frchp/open-lion-charger/README.md

# open-lion-charger
Open source battery charger and discharger

Based on [private archived project](https://github.com/frchp/li-ion-battery-high-current-charger)

TODO :
  1. Manufacturing
  2. Arduino software/library for easy integration
