frchp/open-lion-charger/hw/open-lion-charger/open-lion-charger.kicad_pcb

## KiCad design hw/open-lion-charger/open-lion-charger.kicad_pcb (2025-02-10)

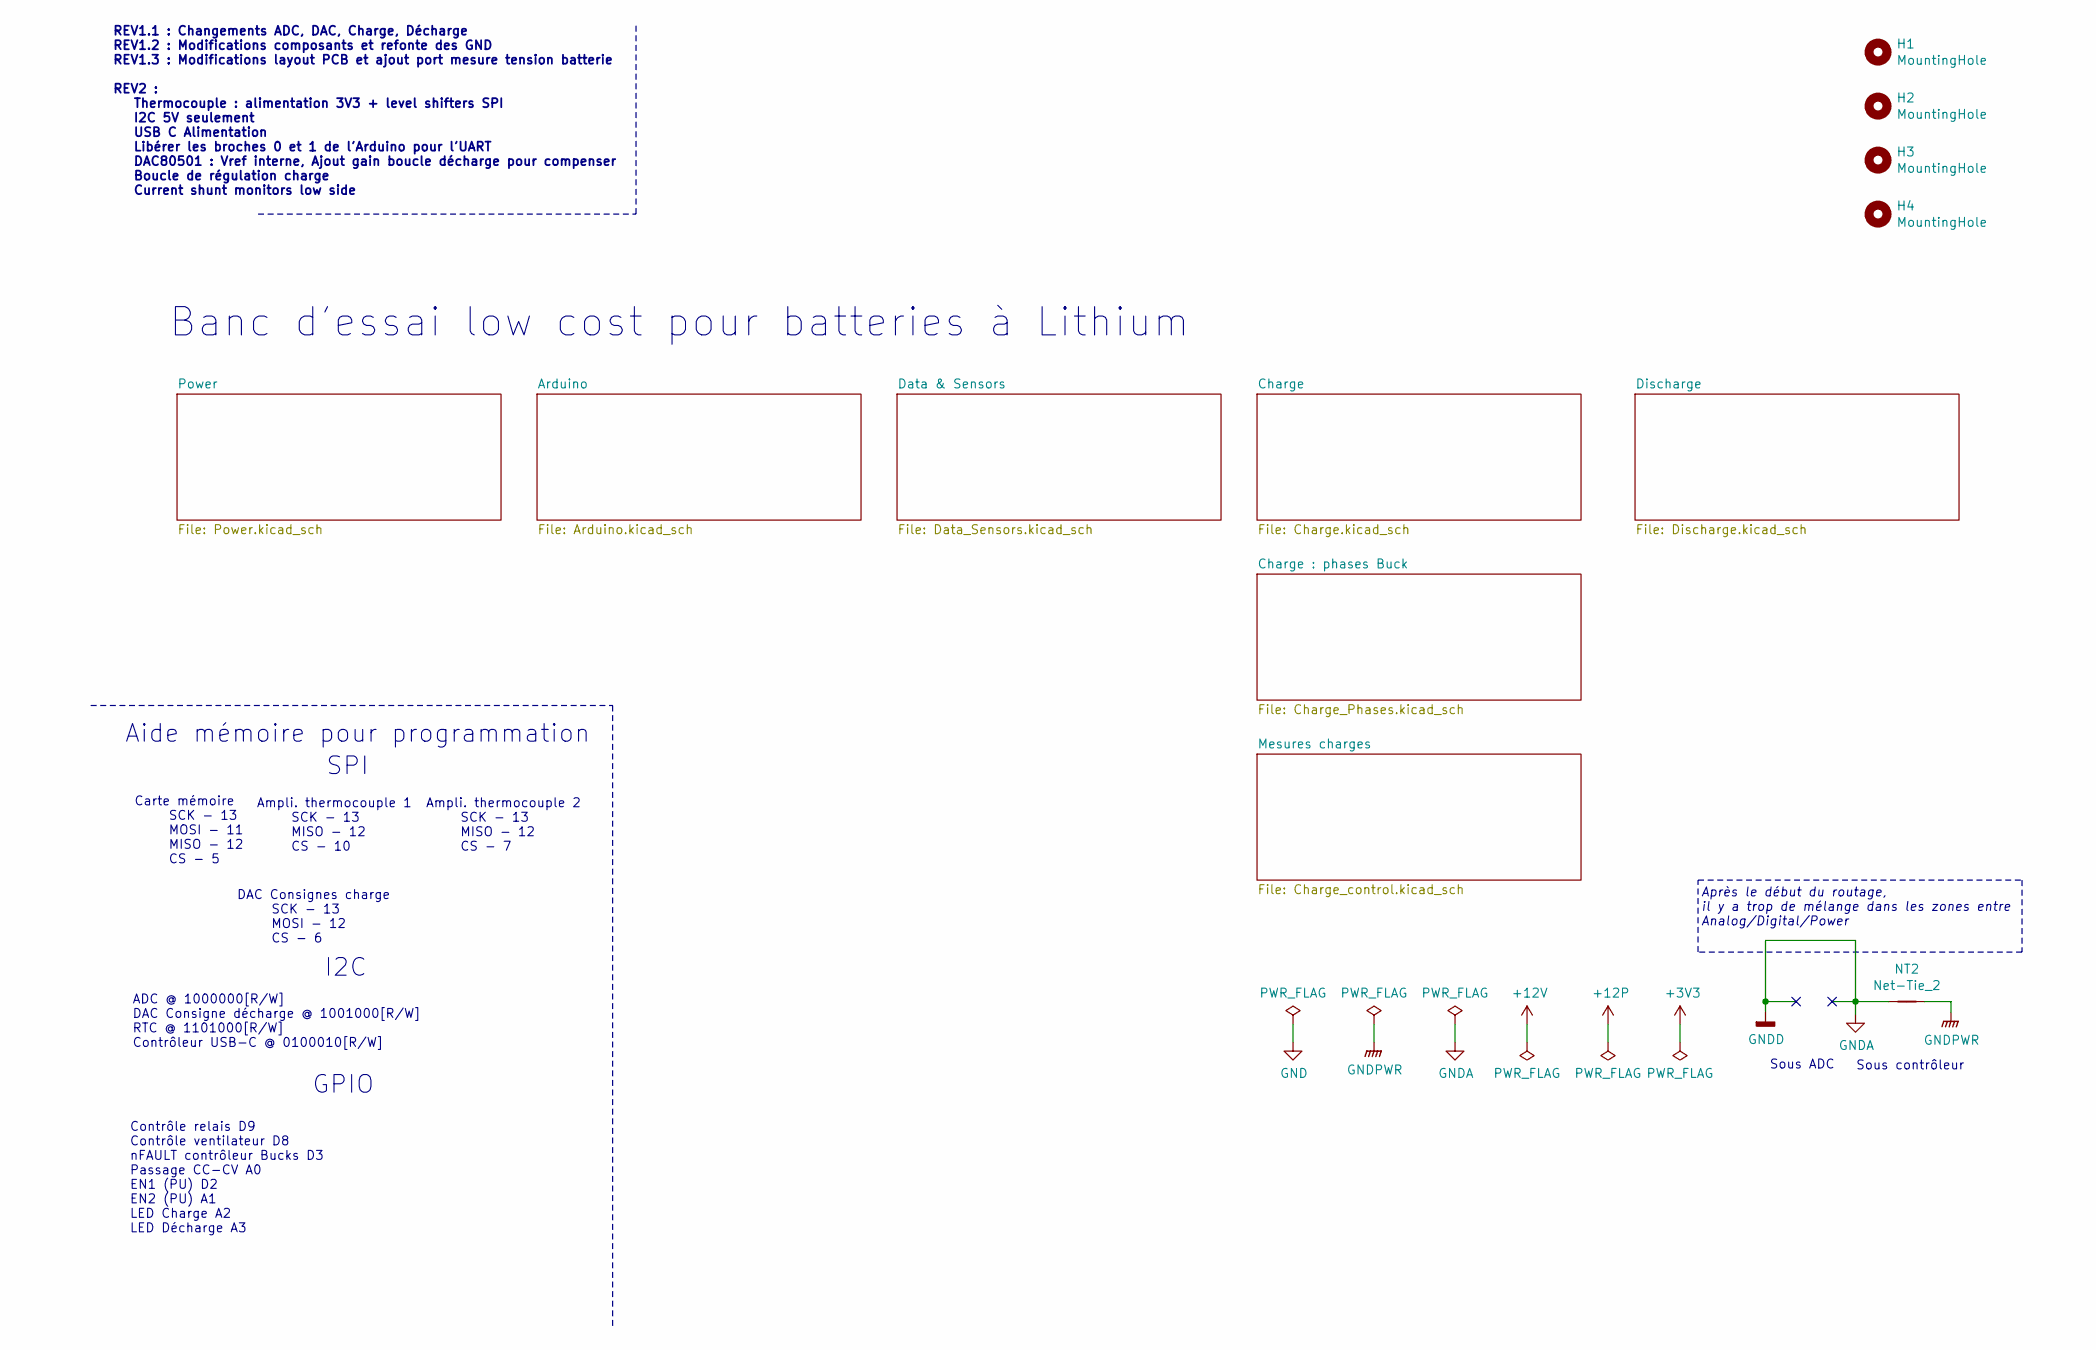
[picture p1: schematic open-lion-charger.kicad_sch, Open LiOn charger]

Parts:
H1, H2, H3, H4: MountingHole; MountingHole_3.2mm_M3_ISO7380
NT2: Net-Tie_2; NetTie-2_SMD_Pad0.5mm

Connections:
GNDA: NT2.1; also elsewhere on the board
GNDPWR: NT2.2; also elsewhere on the board

Notes on the sheet:
Carte mémoire SCK - 13 MOSI - 11 MISO - 12 CS - 5
Ampli. thermocouple 1 SCK - 13 MISO - 12 CS - 10
I2C
Ampli. thermocouple 2 SCK - 13 MISO - 12 CS - 7
REV1.1 : Changements ADC, DAC, Charge, Décharge REV1.2 : Modifications composants et refonte des GND REV1.3 : Modifications layout PCB et ajout port mesure tension batterie REV2 : Thermocouple : alimentation 3V3 + level shifters SPI I2C 5V seulement USB C Alimentation Libérer les broches 0 et 1 de 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
GPIO
Sous contrôleur
DAC Consignes charge SCK - 13 MOSI - 12 CS - 6
Aide mémoire pour programmation
ADC @ 1000000[R/W] DAC Consigne décharge @ 1001000[R/W] RTC @ 1101000[R/W] Contrôleur USB-C @ 0100010[R/W]
Sous ADC
SPI
Contrôle relais D9 Contrôle ventilateur D8 nFAULT contrôleur Bucks D3 Passage CC-CV A0 EN1 (PU) D2 EN2 (PU) A1 LED Charge A2 LED Décharge A3
Après le début du routage, il y a trop de mélange dans les zones entre Analog/Digital/Power
Banc d'essai low cost pour batteries à Lithium

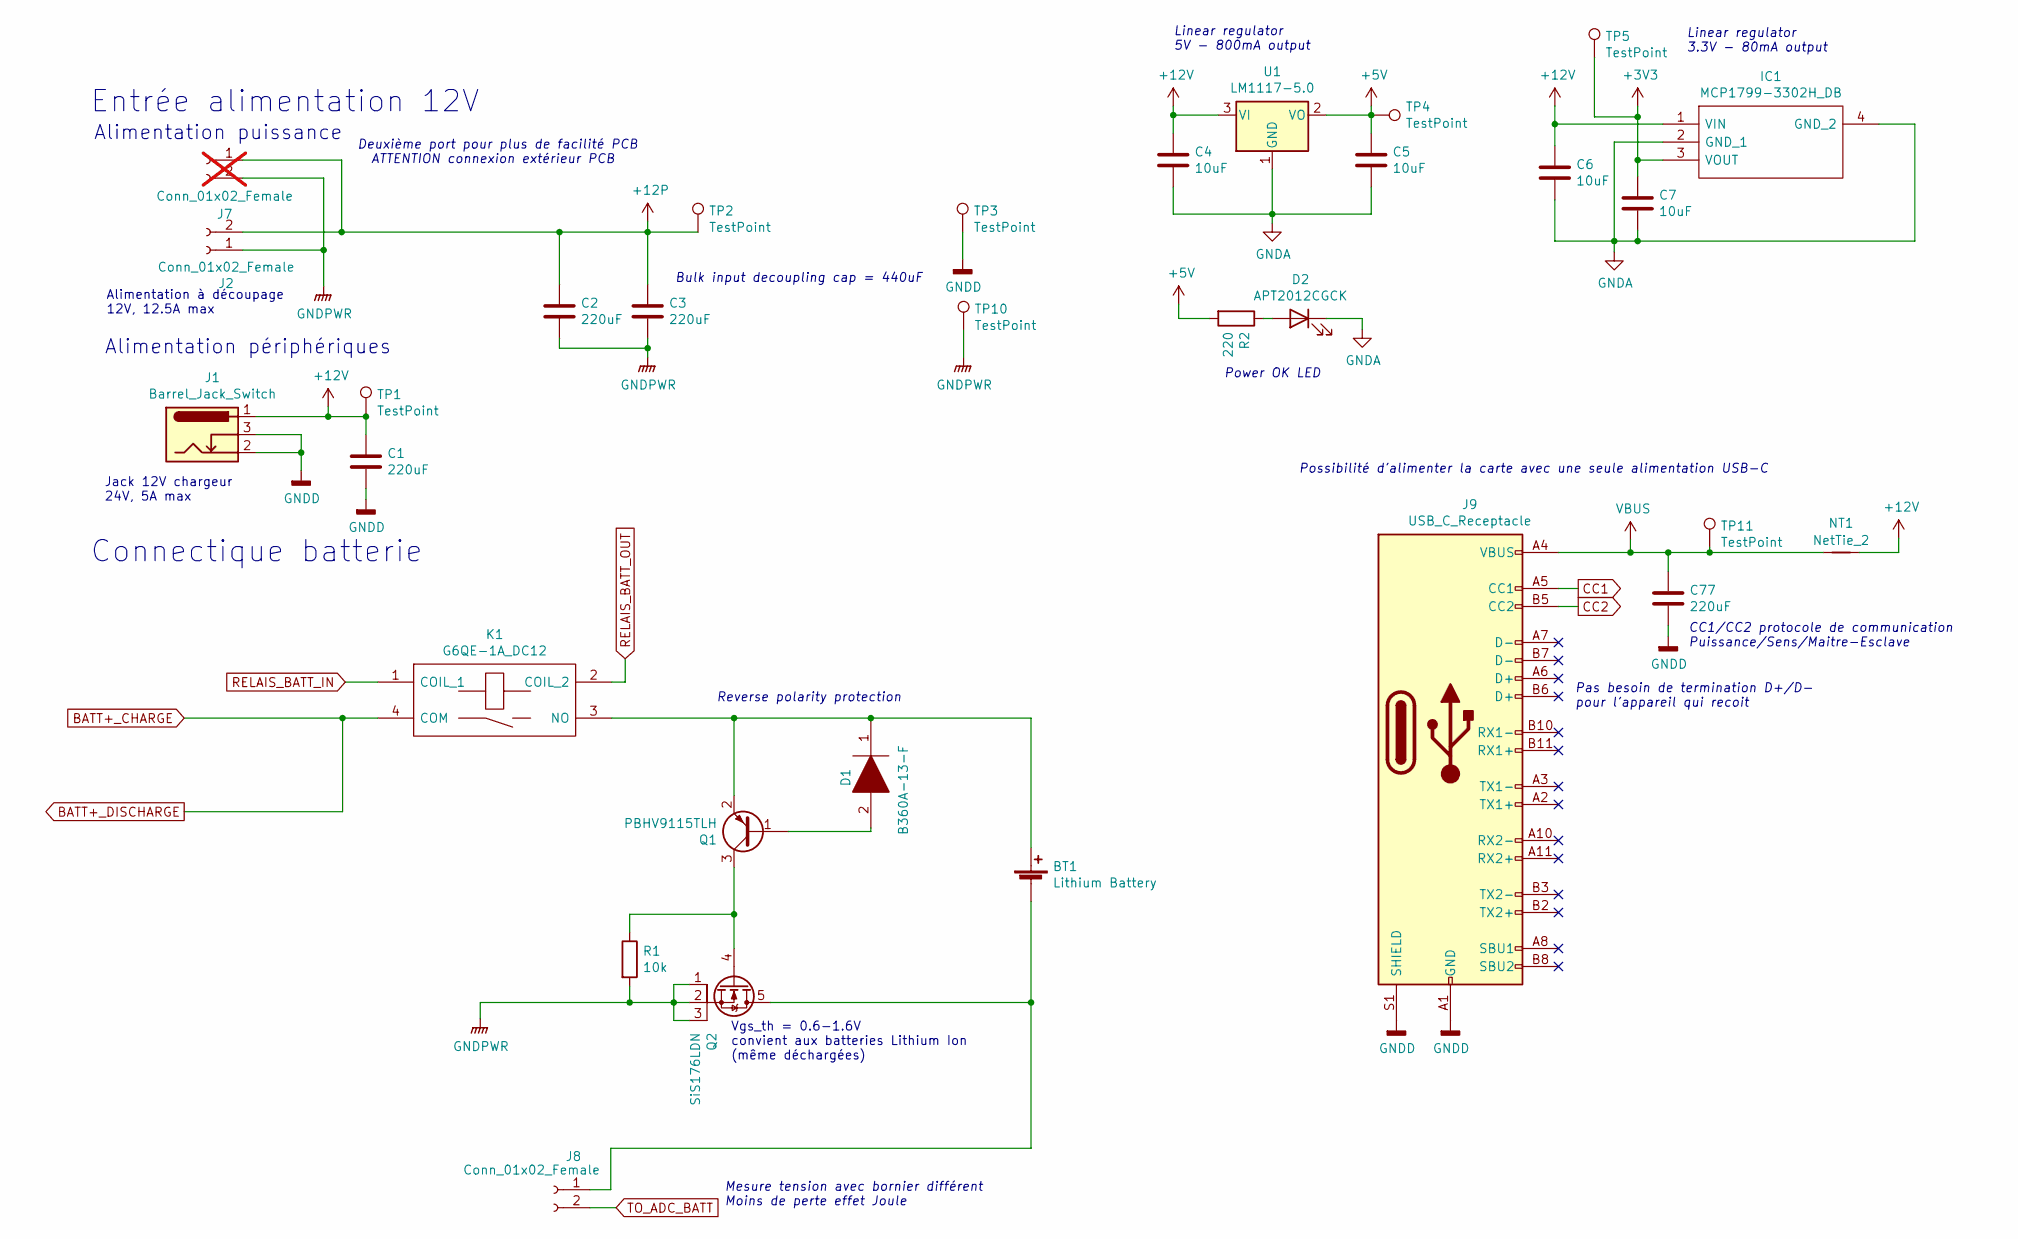
[picture p2: schematic Power.kicad_sch]

Parts:
BT1: Lithium Battery; TerminalBlock_bornier-2_P5.08mm
C1, C2, C3, C77: 220uF; CP_EIA-7343-31_Kemet-D_Pad2.25x2.55mm_HandSolder
C4, C5, C6, C7: 10uF; C_0805_2012Metric
D1: B360A-13-F; DIOM5226X240N; Manufacturer_Part_Number B360A-13-F; Mouser Part Number 621-B360A-F
D2: APT2012CGCK; LED_0805_2012Metric_Pad1.15x1.40mm_HandSolder
IC1: MCP1799-3302H_DB; SOT230P700X180-4N; Manufacturer_Part_Number MCP1799-3302H/DB; Mouser Part Number 579-MCP1799-3302H/DB
J1: Barrel_Jack_Switch; BarrelJack_Wuerth_6941xx301002
J2, J8: Conn_01x02_Female; TerminalBlock_bornier-2_P5.08mm
J7: Conn_01x02_Female; TerminalBlock_bornier-2_P5.08mm; not fitted
J9: USB_C_Receptacle; USB_C_Receptacle_GCT_USB4085
K1: G6QE-1A_DC12; G6QE1ADC12; Manufacturer_Part_Number G6QE-1A DC12; Mouser Part Number 653-G6QE-1ADC12
NT1: NetTie_2; R_2816_7142Metric_Pad3.20x4.45mm_HandSolder
Q1: PBHV9115TLH; SOT-23
Q2: SiS176LDN; Vishay_PowerPAK_1212-8_Single
R1: 10k; R_0805_2012Metric
R2: 220; R_0805_2012Metric
TP1, TP2, TP3, TP4, TP5, TP10, TP11: TestPoint; TestPoint_Keystone_5000-5004_Miniature
U1: LM1117-5.0; SOT-223

Connections:
+3V3: C7.1, IC1.3 (VOUT), TP5.1; also elsewhere on the board
+5V: C5.1, R2.2, TP4.1, U1.2 (VO); also elsewhere on the board
+12P: C2.1, C3.1, J2.2, J7.1, TP2.1; also elsewhere on the board
BATT+_CHARGE: K1.4 (COM); also elsewhere on the board
CC1: J9.A5 (CC1); also elsewhere on the board
CC2: J9.B5 (CC2); also elsewhere on the board
GNDA: C1.2, C4.2, C5.2, C6.2, C7.2, C77.2, D2.1 (K), IC1.2 (GND_1), IC1.4 (GND_2), J1.2, J1.3, J9.A1 (GND), J9.A12 (GND), J9.B1 (GND), J9.B12 (GND), J9.S1 (SHIELD), TP3.1, U1.1 (GND); also elsewhere on the board
GNDPWR: C2.2, C3.2, J2.1, J7.2, Q2.1, Q2.2, Q2.3, R1.2, TP10.1; also elsewhere on the board
unnamed: BT1.1 (+), D1.1, K1.3 (NO), Q1.2 (E)
unnamed: BT1.2 (-), J8.1, Q2.5
unnamed: D2.2 (A), R2.1
unnamed: D1.2, Q1.1 (B)
unnamed: Q1.3 (C), Q2.4, R1.1
RELAIS_BATT_IN: K1.1 (COIL_1); also elsewhere on the board
RELAIS_BATT_OUT: C1.1, C4.1, C6.1, IC1.1 (VIN), J1.1, K1.2 (COIL_2), NT1.2, TP1.1, U1.3 (VI); also elsewhere on the board
TO_ADC_BATT: J8.2; also elsewhere on the board
VBUS: C77.1, J9.A4 (VBUS), J9.A9 (VBUS), J9.B4 (VBUS), J9.B9 (VBUS), NT1.1, TP11.1; also elsewhere on the board

Notes on the sheet:
Alimentation à découpage 12V, 12.5A max
Connectique batterie
Entrée alimentation 12V
Deuxième port pour plus de facilité PCB ATTENTION connexion extérieur PCB
Bulk input decoupling cap = 440uF
CC1/CC2 protocole de communication Puissance/Sens/Maitre-Esclave
Alimentation périphériques
Jack 12V chargeur 24V, 5A max
Power OK LED
Pas besoin de termination D+/D- pour l'appareil qui recoit
Vgs_th = 0.6-1.6V convient aux batteries Lithium Ion (même déchargées)
Alimentation puissance
Mesure tension avec bornier différent Moins de perte effet Joule
Linear regulator 5V - 800mA output
Reverse polarity protection
Possibilité d'alimenter la carte avec une seule alimentation USB-C
Linear regulator 3.3V - 80mA output

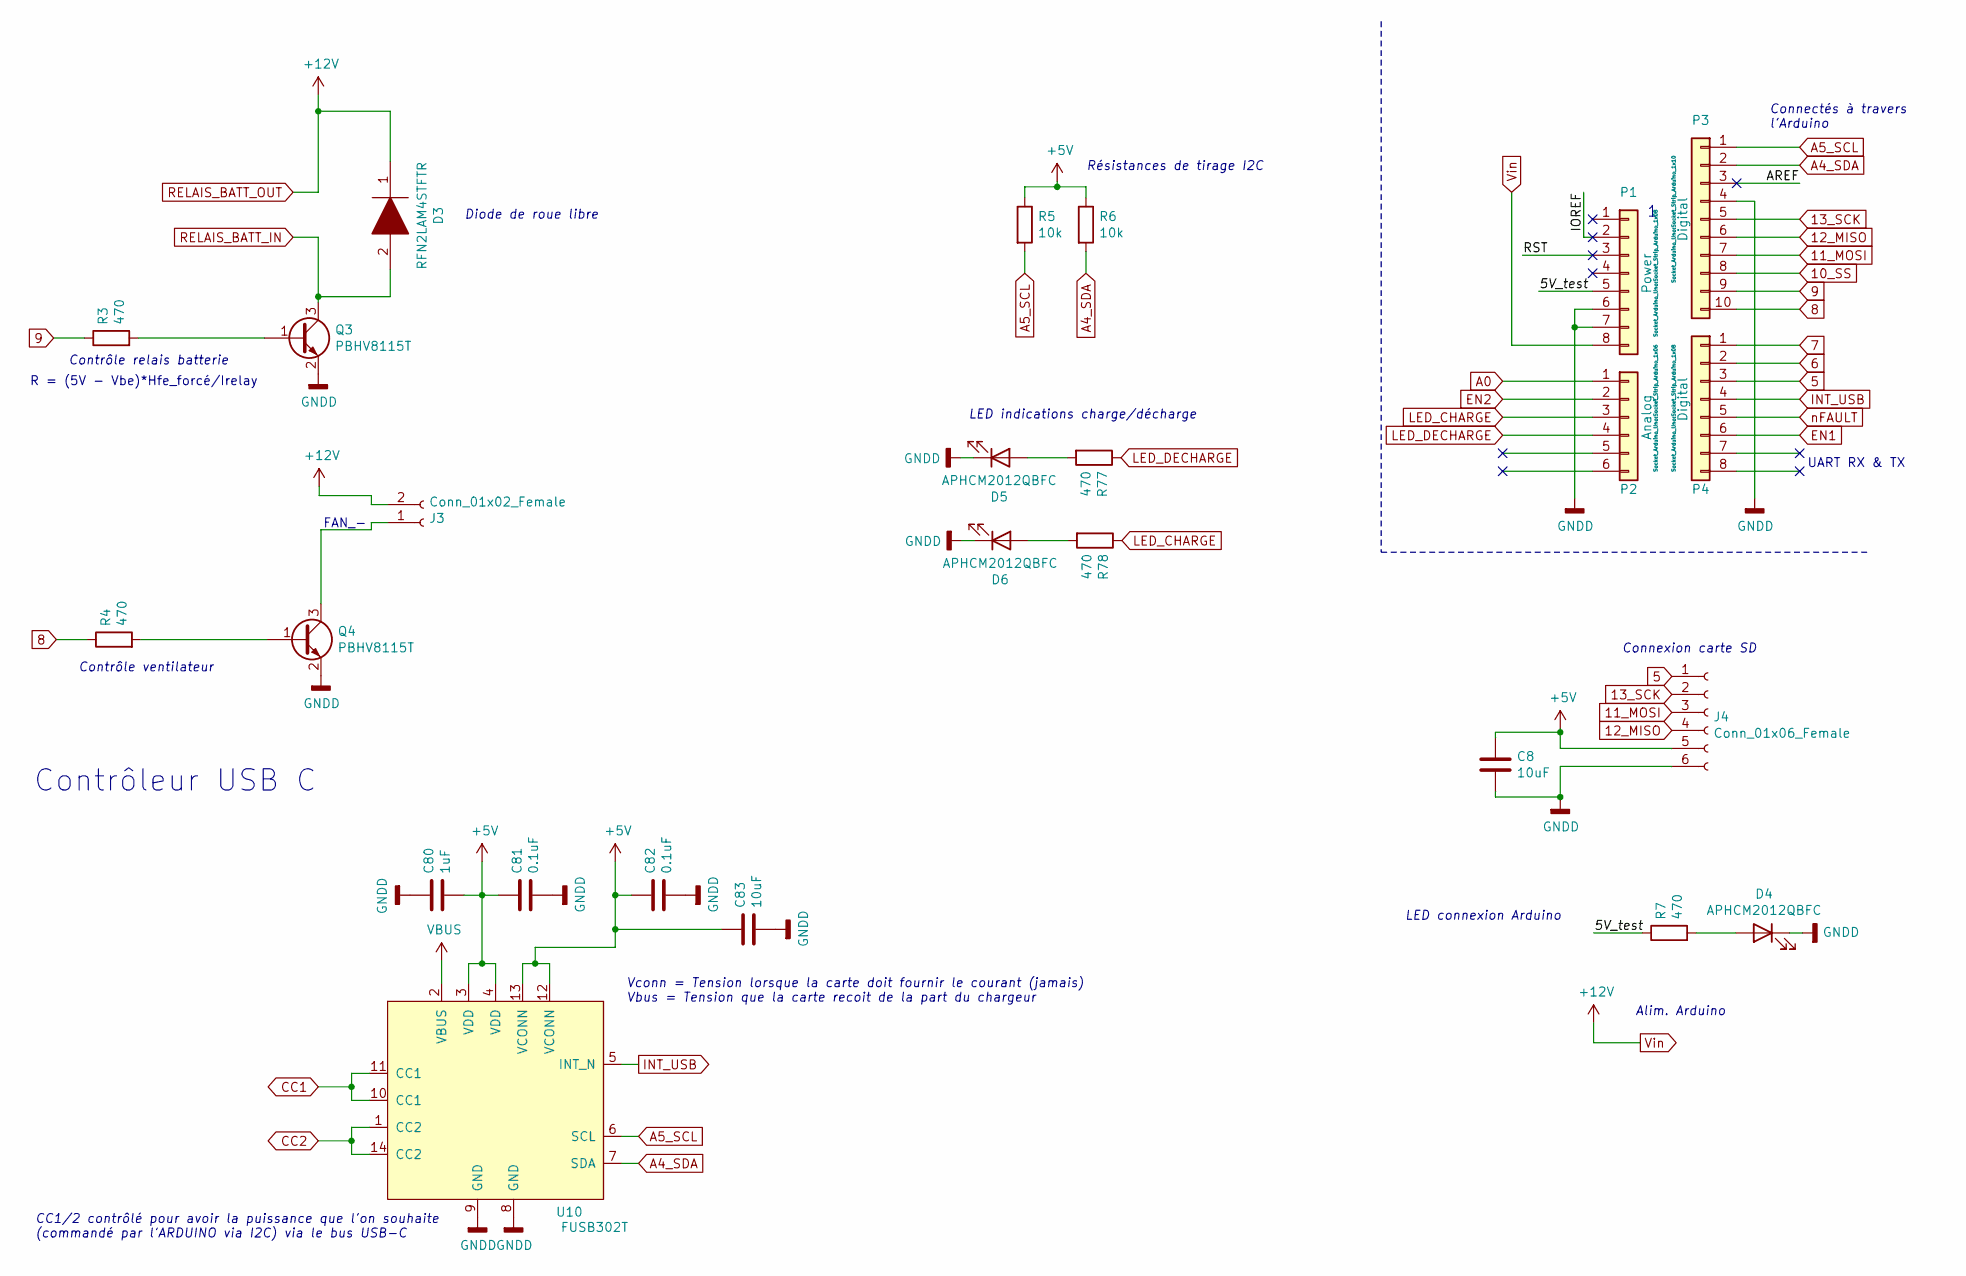
[picture p3: schematic Arduino.kicad_sch]

Parts:
C8, C83: 10uF; C_0805_2012Metric
C80: 1uF; C_0805_2012Metric
C81, C82: 0.1uF; C_0805_2012Metric
D3: RFN2LAM4STFTR; SODFL4725X105N; Manufacturer_Part_Number RFN2LAM4STFTR; Mouser Part Number 755-RFN2LAM4STFTR
D4, D5, D6: APHCM2012QBFC; LED_0805_2012Metric_Pad1.15x1.40mm_HandSolder
J3: Conn_01x02_Female; TerminalBlock_bornier-2_P5.08mm
J4: Conn_01x06_Female; PinSocket_1x06_P2.54mm_Vertical
P1: Power; Socket_Strip_Arduino_1x08
P2: Analog; Socket_Strip_Arduino_1x06
P3: Digital; Socket_Strip_Arduino_1x10
P4: Digital; Socket_Strip_Arduino_1x08
Q3, Q4: PBHV8115T; SOT-23
R3, R4, R7, R77, R78: 470; R_0805_2012Metric
R5, R6: 10k; R_0805_2012Metric
U10: FUSB302T; WQFN-14-1EP_2.5x2.5mm_P0.5mm_EP1.45x1.45mm

Connections:
5: J4.1, P4.3
6: P4.2; also elsewhere on the board
7: P4.1; also elsewhere on the board
8: P3.10, R4.1
9: P3.9, R3.1
10_SS: P3.8; also elsewhere on the board
11_MOSI: J4.3, P3.7; also elsewhere on the board
12_MISO: J4.4, P3.6; also elsewhere on the board
13_SCK: J4.2, P3.5; also elsewhere on the board
+5V: C8.1, C80.2, C81.1, C82.1, C83.1, J4.5, R5.1, R6.1, U10.3 (VDD), U10.4 (VDD), U10.12 (VCONN), U10.13 (VCONN); also elsewhere on the board
/Arduino/5V_test: P1.5, R7.1
/Arduino/AREF: P3.3
/Arduino/IOREF: P1.2
/Arduino/RST: P1.3
A0: P2.1; also elsewhere on the board
A4_SDA: P3.2, R6.2, U10.7 (SDA); also elsewhere on the board
A5_SCL: P3.1, R5.2, U10.6 (SCL); also elsewhere on the board
CC1: U10.10 (CC1), U10.11 (CC1); also elsewhere on the board
CC2: U10.1 (CC2), U10.14 (CC2); also elsewhere on the board
EN1: P4.6; also elsewhere on the board
EN2: P2.2; also elsewhere on the board
GNDA: C8.2, C80.1, C81.2, C82.2, C83.2, D4.1 (K), D5.1 (K), D6.1 (K), J4.6, P1.6, P1.7, P3.4, Q3.2 (E), Q4.2 (E), U10.8 (GND), U10.9 (GND); also elsewhere on the board
INT_USB: P4.4, U10.5 (INT_N)
LED_CHARGE: P2.3, R78.1
LED_DECHARGE: P2.4, R77.1
unnamed: D4.2 (A), R7.2
unnamed: D5.2 (A), R77.2
unnamed: D6.2 (A), R78.2
unnamed: J3.1, Q4.3 (C)
unnamed: Q3.1 (B), R3.2
unnamed: Q4.1 (B), R4.2
RELAIS_BATT_IN: D3.2, Q3.3 (C); also elsewhere on the board
RELAIS_BATT_OUT: D3.1, J3.2, P1.8; also elsewhere on the board
VBUS: U10.2 (VBUS); also elsewhere on the board
nFAULT: P4.5; also elsewhere on the board

Notes on the sheet:
FAN_-
Alim. Arduino
Diode de roue libre
Contrôleur USB C
Connexion carte SD
Résistances de tirage I2C
R = (5V - Vbe)*Hfe_forcé/Irelay
LED indications charge/décharge
LED connexion Arduino
Vconn = Tension lorsque la carte doit fournir le courant (jamais) Vbus = Tension que la carte recoit de la part du chargeur
Connectés à travers l'Arduino
CC1/2 contrôlé pour avoir la puissance que l'on souhaite (commandé par l'ARDUINO via I2C) via le bus USB-C
Contrôle relais batterie
Contrôle ventilateur
UART RX & TX

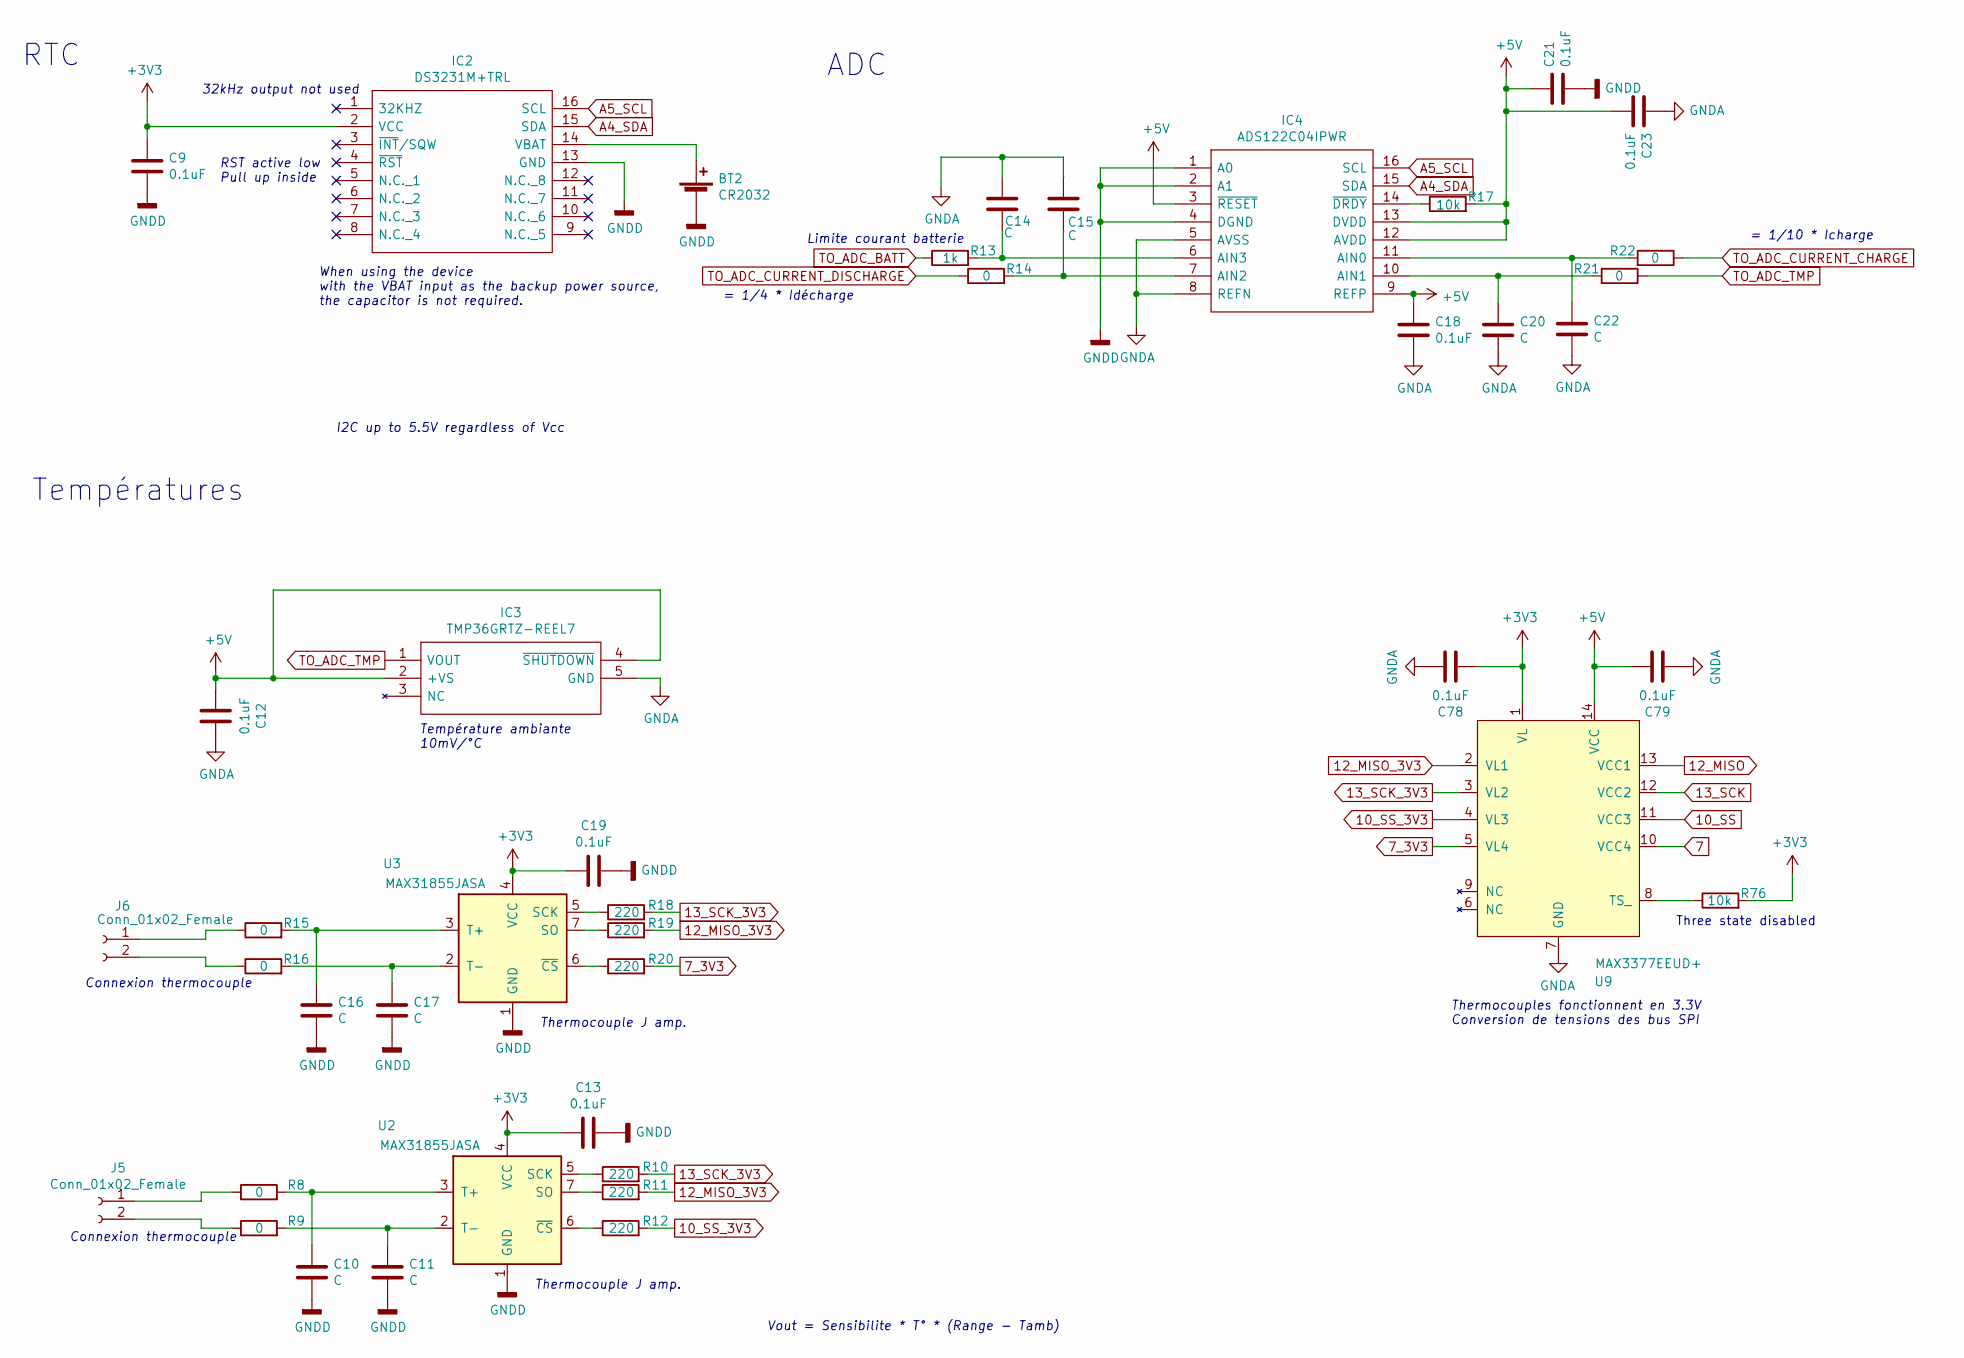
[picture p4: schematic Data_Sensors.kicad_sch]

Parts:
BT2: CR2032; BATHLD001TR
C9, C12, C13, C18, C19, C21, C23, C78, C79: 0.1uF; C_0805_2012Metric
C10, C11, C14, C15, C16, C17, C20, C22: C; C_0805_2012Metric
IC2: DS3231M+TRL; SOIC127P1032X265-16N; Manufacturer_Part_Number DS3231M+TRL; Mouser Part Number 700-DS3231M+TRL
IC3: TMP36GRTZ-REEL7; SOT95P280X145-5N; Manufacturer_Part_Number TMP36GRTZ-REEL7; Mouser Part Number 584-TMP36GRTZ-R7
IC4: ADS122C04IPWR; SOP65P640X120-16N; Manufacturer_Part_Number ADS122C04IPWR; Mouser Part Number 595-ADS122C04IPWR
J5, J6: Conn_01x02_Female; PinSocket_2x01_P1.27mm_Vertical
R8, R9, R14, R15, R16, R21, R22: 0; R_0805_2012Metric
R10, R11, R12, R18, R19, R20: 220; R_0805_2012Metric
R13: 1k; R_0805_2012Metric
R17, R76: 10k; R_0805_2012Metric
U2, U3: MAX31855JASA; SOIC-8_3.9x4.9mm_P1.27mm
U9: MAX3377EEUD+; TSSOP-14_4.4x5mm_P0.65mm

Connections:
7: U9.10 (VCC4); also elsewhere on the board
7_3V3: R20.2, U9.5 (VL4)
10_SS: U9.11 (VCC3); also elsewhere on the board
10_SS_3V3: R12.2, U9.4 (VL3)
12_MISO: U9.13 (VCC1); also elsewhere on the board
12_MISO_3V3: R11.2, R19.2, U9.2 (VL1)
13_SCK: U9.12 (VCC2); also elsewhere on the board
13_SCK_3V3: R10.2, R18.2, U9.3 (VL2)
+3V3: C9.1, C13.2, C19.2, C78.2, IC2.2 (VCC), R76.2, U2.4 (VCC), U3.4 (VCC), U9.1 (VL); also elsewhere on the board
+5V: C12.2, C18.1, C21.1, C23.2, C79.2, IC3.2 (+VS), IC3.4 (~SHUTDOWN), IC4.3 (~RESET), IC4.9 (REFP), IC4.12 (AVDD), IC4.13 (DVDD), R17.2, U9.14 (VCC); also elsewhere on the board
A4_SDA: IC2.15 (SDA), IC4.15 (SDA); also elsewhere on the board
A5_SCL: IC2.16 (SCL), IC4.16 (SCL); also elsewhere on the board
FB_COURANT: R14.1; also elsewhere on the board
GNDA: BT2.2 (-), C9.2, C10.1, C11.1, C12.1, C13.1, C14.2, C15.2, C16.1, C17.1, C18.2, C19.1, C20.1, C21.2, C22.1, C23.1, C78.1, C79.1, IC2.13 (GND), IC3.5 (GND), IC4.1 (A0), IC4.2 (A1), IC4.4 (DGND), IC4.5 (AVSS), IC4.8 (REFN), U2.1 (GND), U3.1 (GND), U9.7 (GND); also elsewhere on the board
unnamed: BT2.1 (+), IC2.14 (VBAT)
unnamed: C22.2, IC4.11 (AIN0), R22.2
unnamed: C20.2, IC4.10 (AIN1), R21.2
unnamed: C15.1, IC4.7 (AIN2), R14.2
unnamed: C14.1, IC4.6 (AIN3), R13.2
unnamed: IC4.14 (~DRDY), R17.1
unnamed: J5.1, R8.1
unnamed: J5.2, R9.1
unnamed: J6.1, R15.1
unnamed: J6.2, R16.1
unnamed: R10.1, U2.5 (SCK)
unnamed: R11.1, U2.7 (SO)
unnamed: C10.2, R8.2, U2.3 (T+)
unnamed: C11.2, R9.2, U2.2 (T-)
unnamed: R12.1, U2.6 (~CS)
unnamed: R18.1, U3.5 (SCK)
unnamed: R19.1, U3.7 (SO)
unnamed: C16.2, R15.2, U3.3 (T+)
unnamed: C17.2, R16.2, U3.2 (T-)
unnamed: R20.1, U3.6 (~CS)
unnamed: R76.1, U9.8 (TS_)
TO_ADC_BATT: R13.1; also elsewhere on the board
TO_ADC_CURRENT_CHARGE: R22.1; also elsewhere on the board
TO_ADC_TMP: IC3.1 (VOUT), R21.1

Notes on the sheet:
Limite courant batterie
ADC
= 1/4 * Idécharge
Thermocouple J amp.
Connexion thermocouple
RTC
Température ambiante 10mV/°C
32kHz output not used
When using the device with the VBAT input as the backup power source, the capacitor is not required.
I2C up to 5.5V regardless of Vcc
Températures
Three state disabled
Thermocouples fonctionnent en 3.3V Conversion de tensions des bus SPI
= 1/10 * Icharge
Vout = Sensibilite * T° * (Range - Tamb)
RST active low Pull up inside

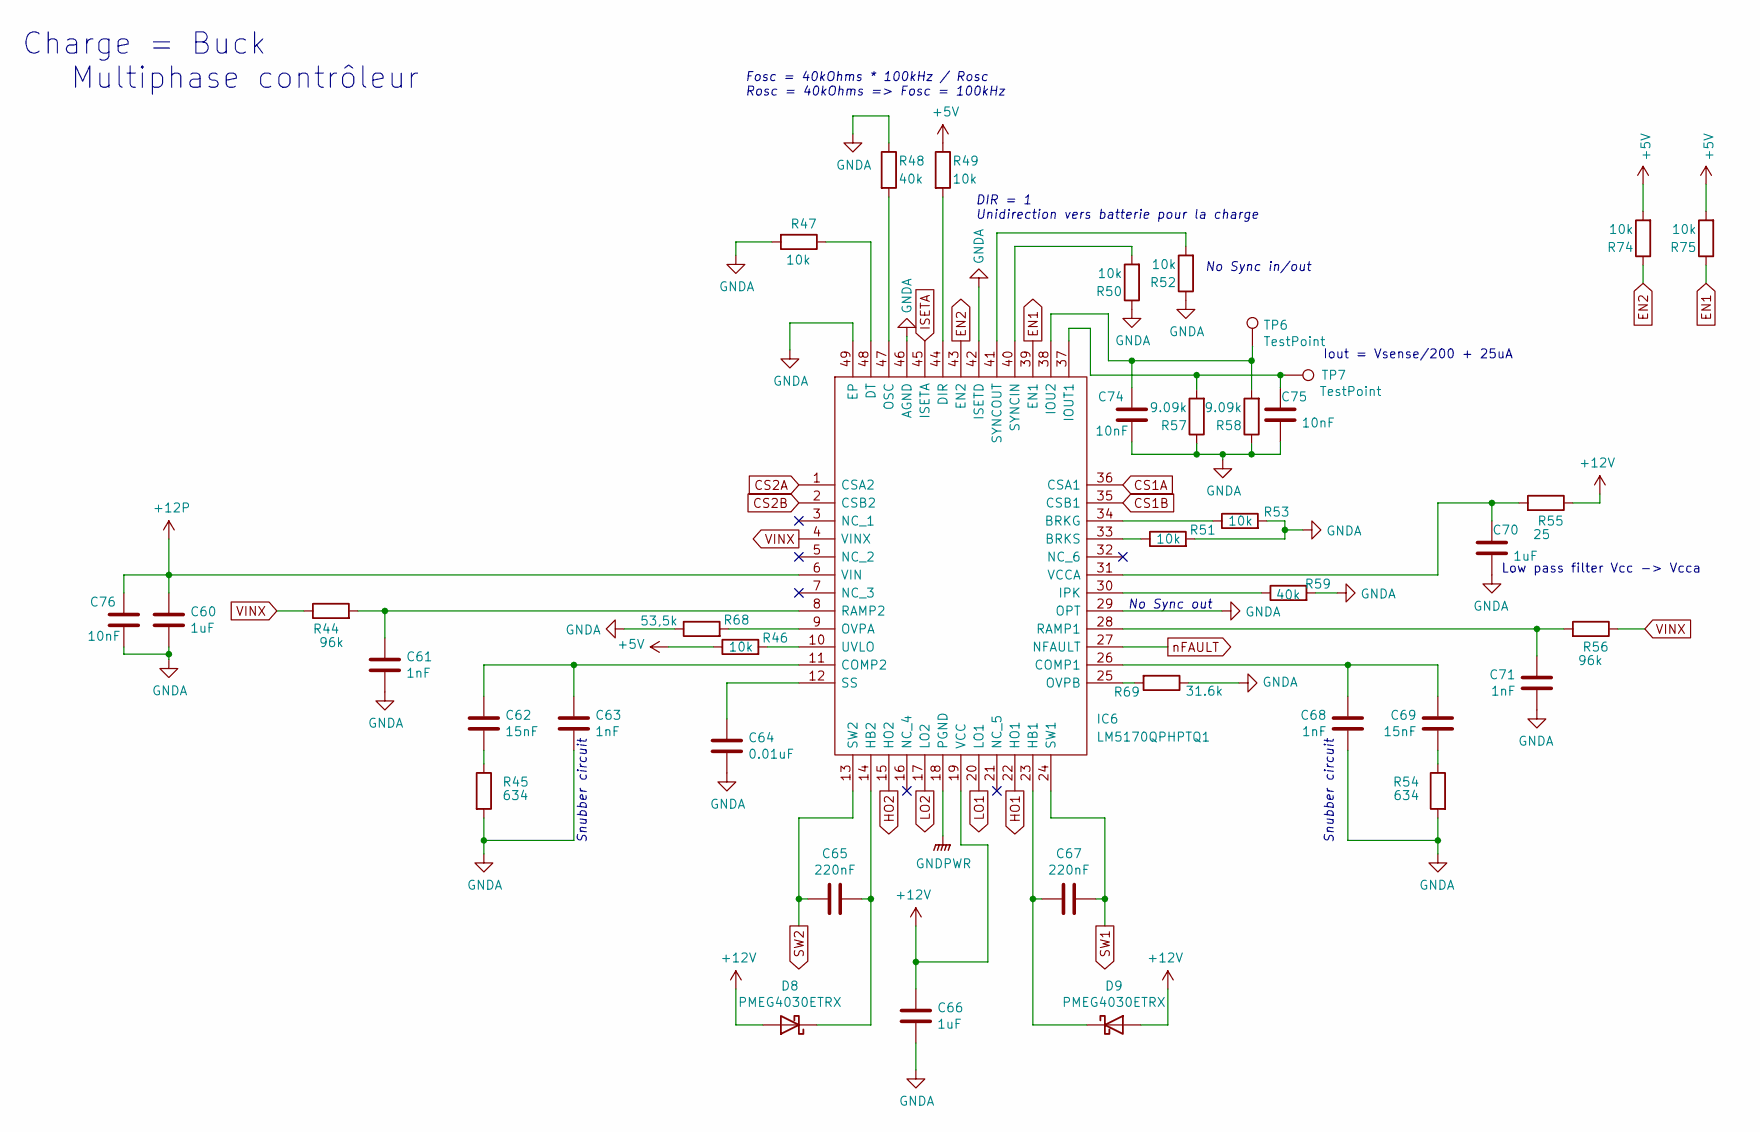
[picture p5: schematic Charge.kicad_sch]

Parts:
C60, C66, C70: 1uF; C_0805_2012Metric
C61, C63, C68, C71: 1nF; C_0805_2012Metric
C62, C69: 15nF; C_0805_2012Metric
C64: 0.01uF; C_0805_2012Metric
C65, C67: 220nF; C_0805_2012Metric
C74, C75, C76: 10nF; C_0805_2012Metric
D8, D9: PMEG4030ETRX; SODFL4725X105N
IC6: LM5170QPHPTQ1; QFP50P900X900X120-49N; Manufacturer_Part_Number LM5170QPHPTQ1; Mouser Part Number 595-LM5170QPHPTQ1
R44, R56: 96k; R_0805_2012Metric
R45, R54: 634; R_0805_2012Metric
R46, R47, R49, R50, R51, R52, R53, R74, R75: 10k; R_0805_2012Metric
R48, R59: 40k; R_0805_2012Metric
R55: 25; R_0805_2012Metric
R57, R58: 9.09k; R_0805_2012Metric
R68: 53,5k; R_0805_2012Metric
R69: 31.6k; R_0805_2012Metric
TP6, TP7: TestPoint; TestPoint_Keystone_5000-5004_Miniature

Connections:
+5V: R46.1, R49.1, R74.2, R75.2; also elsewhere on the board
+12P: C60.1, C76.1, IC6.6 (VIN); also elsewhere on the board
CS1A: IC6.36 (CSA1); also elsewhere on the board
CS1B: IC6.35 (CSB1); also elsewhere on the board
CS2A: IC6.1 (CSA2); also elsewhere on the board
CS2B: IC6.2 (CSB2); also elsewhere on the board
EN1: IC6.39 (EN1), R75.1; also elsewhere on the board
EN2: IC6.43 (EN2), R74.1; also elsewhere on the board
GNDA: C60.2, C61.2, C63.2, C64.2, C66.2, C68.2, C70.2, C71.2, C74.2, C75.2, C76.2, IC6.29 (OPT), IC6.42 (ISETD), IC6.46 (AGND), IC6.49 (EP), R45.2, R47.2, R48.1, R50.1, R51.2, R52.1, R53.2, R54.2, R57.1, R58.1, R59.2, R68.1, R69.1; also elsewhere on the board
GNDPWR: IC6.18 (PGND); also elsewhere on the board
HO1: IC6.22 (HO1); also elsewhere on the board
HO2: IC6.15 (HO2); also elsewhere on the board
ISETA: IC6.45 (ISETA); also elsewhere on the board
LO1: IC6.20 (LO1); also elsewhere on the board
LO2: IC6.17 (LO2); also elsewhere on the board
unnamed: C62.2, R45.1
unnamed: C69.2, R54.1
unnamed: C65.2, D8.1 (K), IC6.14 (HB2)
unnamed: C67.2, D9.1 (K), IC6.23 (HB1)
unnamed: IC6.34 (BRKG), R53.1
unnamed: IC6.33 (BRKS), R51.1
unnamed: C68.1, C69.1, IC6.26 (COMP1)
unnamed: C62.1, C63.1, IC6.11 (COMP2)
unnamed: IC6.44 (DIR), R49.2
unnamed: IC6.48 (DT), R47.1
unnamed: C74.1, IC6.38 (IOU2), R58.2, TP6.1
unnamed: C75.1, IC6.37 (IOUT1), R57.2, TP7.1
unnamed: IC6.30 (IPK), R59.1
unnamed: IC6.47 (OSC), R48.2
unnamed: IC6.9 (OVPA), R68.2
unnamed: IC6.25 (OVPB), R69.2
unnamed: C71.1, IC6.28 (RAMP1), R56.2
unnamed: C61.1, IC6.8 (RAMP2), R44.2
unnamed: C64.1, IC6.12 (SS)
unnamed: IC6.40 (SYNCIN), R50.2
unnamed: IC6.41 (SYNCOUT), R52.2
unnamed: IC6.10 (UVLO), R46.2
unnamed: C70.1, IC6.31 (VCCA), R55.2
RELAIS_BATT_OUT: C66.1, D8.2 (A), D9.2 (A), IC6.19 (VCC), R55.1; also elsewhere on the board
SW1: C67.1, IC6.24 (SW1); also elsewhere on the board
SW2: C65.1, IC6.13 (SW2); also elsewhere on the board
VINX: IC6.4 (VINX), R44.1, R56.1
nFAULT: IC6.27 (NFAULT); also elsewhere on the board

Notes on the sheet:
Snubber circuit
Iout = Vsense/200 + 25uA
DIR = 1 Unidirection vers batterie pour la charge
Fosc = 40kOhms * 100kHz / Rosc Rosc = 40kOhms => Fosc = 100kHz
Charge = Buck Multiphase contrôleur
Low pass filter Vcc -> Vcca
No Sync in/out
No Sync out

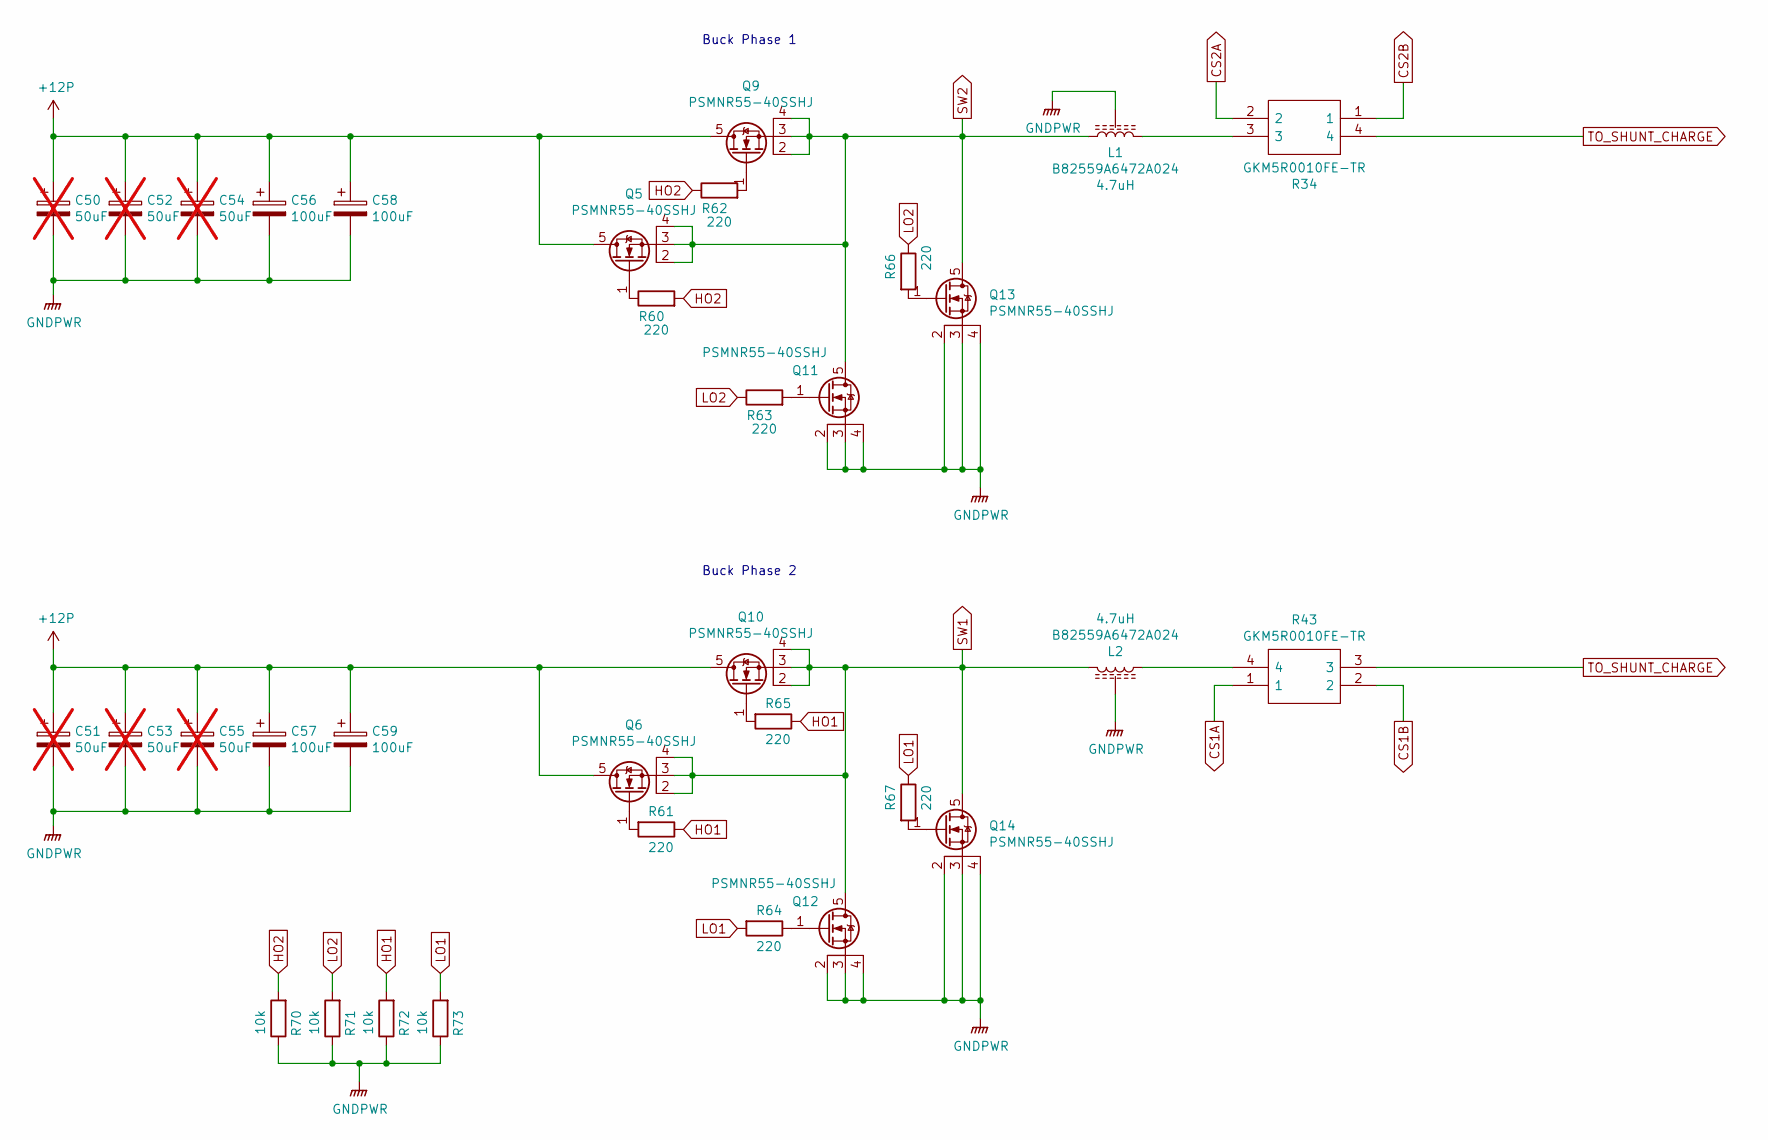
[picture p6: schematic Charge_Phases.kicad_sch]

Parts:
C50, C51, C52, C53, C54, C55: 50uF; SMD_Lytic_E; not fitted
C56, C57, C58, C59: 100uF; EEEFP0J331AV
L1, L2: B82559A6472A024
Q5, Q6, Q9, Q10, Q11, Q12, Q13, Q14: PSMNR55-40SSHJ; LFPAK88
R34, R43: GKM5R0010FE-TR; WSLP40261L000FEA; Manufacturer_Part_Number GKM5R0010FE-TR; Mouser Part Number 588-GKM5R0010FE-TR
R60, R61, R62, R63, R64, R65, R66, R67: 220; R_0805_2012Metric
R70, R71, R72, R73: 10k; R_0805_2012Metric

Connections:
+12P: C50.1, C51.1, C52.1, C53.1, C54.1, C55.1, C56.1, C57.1, C58.1, C59.1, Q5.5, Q6.5, Q9.5, Q10.5; also elsewhere on the board
CS1A: R43.1; also elsewhere on the board
CS1B: R43.2; also elsewhere on the board
CS2A: R34.2; also elsewhere on the board
CS2B: R34.1; also elsewhere on the board
GNDPWR: C50.2, C51.2, C52.2, C53.2, C54.2, C55.2, C56.2, C57.2, C58.2, C59.2, L1.3, L2.3, Q11.2, Q11.3, Q11.4, Q12.2, Q12.3, Q12.4, Q13.2, Q13.3, Q13.4, Q14.2, Q14.3, Q14.4, R70.1, R71.1, R72.1, R73.1; also elsewhere on the board
HO1: R61.1, R65.1, R72.2; also elsewhere on the board
HO2: R60.2, R62.1, R70.2; also elsewhere on the board
LO1: R64.2, R67.1, R73.2; also elsewhere on the board
LO2: R63.1, R66.1, R71.2; also elsewhere on the board
unnamed: L1.2, R34.3
unnamed: L2.1, R43.4
unnamed: Q5.1, R60.1
unnamed: Q6.1, R61.2
unnamed: Q9.1, R62.2
unnamed: Q10.1, R65.2
unnamed: Q11.1, R63.2
unnamed: Q12.1, R64.1
unnamed: Q13.1, R66.2
unnamed: Q14.1, R67.2
SW1: L2.2, Q6.2, Q6.3, Q6.4, Q10.2, Q10.3, Q10.4, Q12.5, Q14.5; also elsewhere on the board
SW2: L1.1, Q5.2, Q5.3, Q5.4, Q9.2, Q9.3, Q9.4, Q11.5, Q13.5; also elsewhere on the board
TO_SHUNT_CHARGE: R34.4, R43.3; also elsewhere on the board

Notes on the sheet:
Buck Phase 2
Buck Phase 1
