frchp/open-lion-charger/hw/open-lion-charger/open-lion-charger.kicad_pcb

## KiCad design hw/open-lion-charger/open-lion-charger.kicad_pcb (continued)

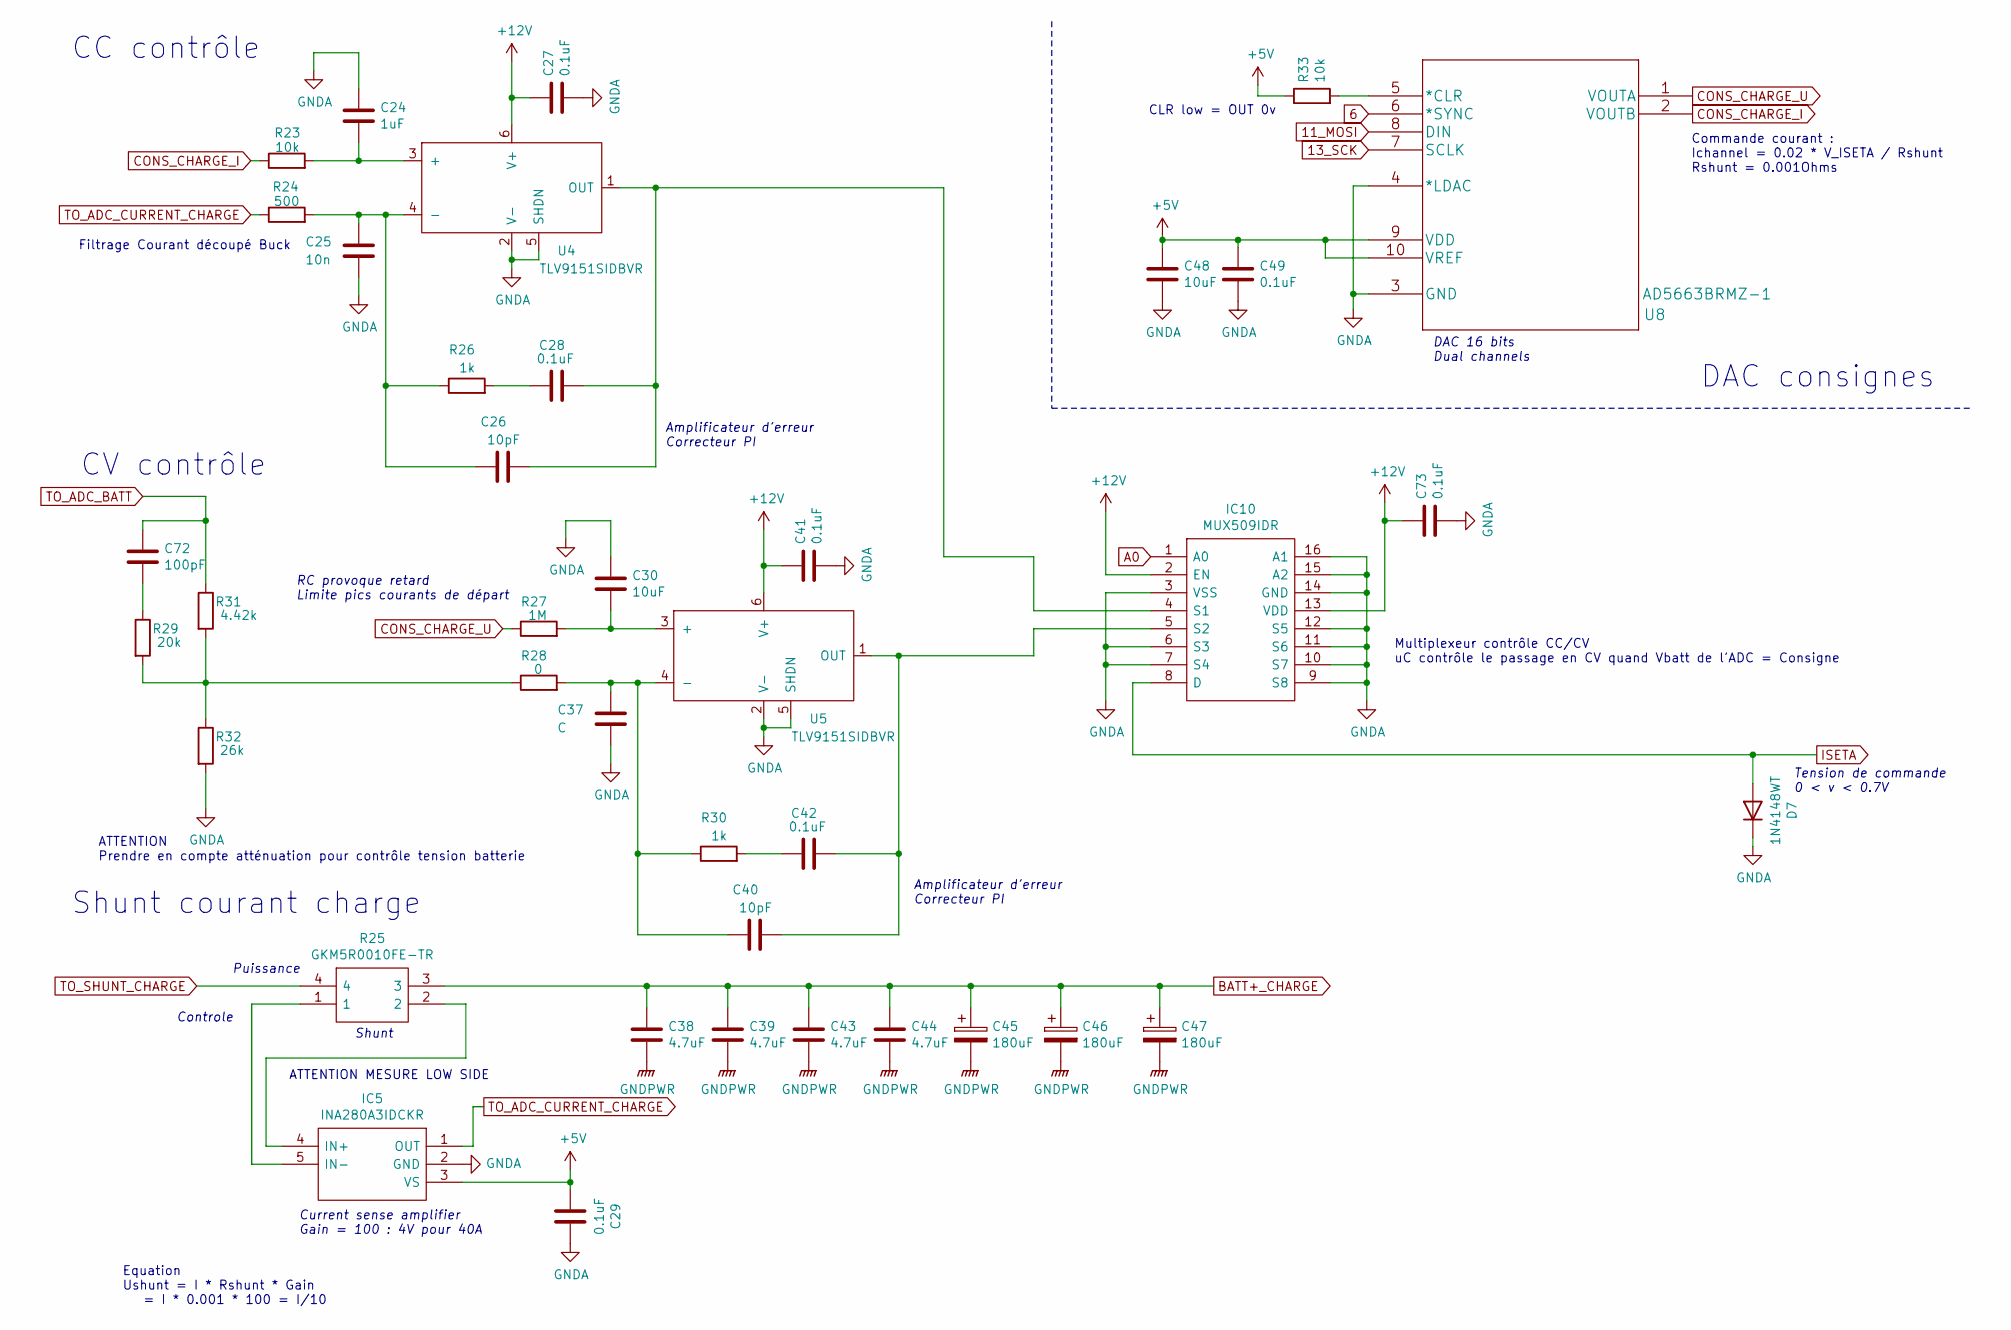
[picture p7: schematic Charge_control.kicad_sch]

Parts:
C24: 1uF; C_0805_2012Metric
C25: 10n; C_0805_2012Metric
C26, C40: 10pF; C_0805_2012Metric
C27, C28, C29, C41, C42, C49, C73: 0.1uF; C_0805_2012Metric
C30, C48: 10uF; C_0805_2012Metric
C37: C; C_0805_2012Metric
C38, C39, C43, C44: 4.7uF; C_0805_2012Metric
C45, C46, C47: 180uF; VibrationProof_F
C72: 100pF; C_0805_2012Metric
D7: 1N4148WT; SODFL1608X70N
IC5: INA280A3IDCKR; SOT65P210X110-5N; Manufacturer_Part_Number INA280A3IDCKR; Mouser Part Number 595-INA280A3IDCKR
IC10: MUX509IDR; SOIC127P600X175-16N; Manufacturer_Part_Number MUX509IDR; Mouser Part Number 595-MUX509IDR
R23, R33: 10k; R_0805_2012Metric
R24: 500; R_0805_2012Metric
R25: GKM5R0010FE-TR; WSLP40261L000FEA; Manufacturer_Part_Number GKM5R0010FE-TR; Mouser Part Number 588-GKM5R0010FE-TR
R26, R30: 1k; R_0805_2012Metric
R27: 1M; R_0805_2012Metric
R28: 0; R_0805_2012Metric
R29: 20k; R_0805_2012Metric
R31: 4.42k; R_0805_2012Metric
R32: 26k; R_0805_2012Metric
U4, U5: TLV9151SIDBVR; SOT-23-6_Handsoldering
U8: AD5663BRMZ-1

Connections:
6: U8.6 (*SYNC); also elsewhere on the board
11_MOSI: U8.8 (DIN); also elsewhere on the board
13_SCK: U8.7 (SCLK); also elsewhere on the board
+5V: C29.2, C48.1, C49.1, IC5.3 (VS), R33.1, U8.9 (VDD), U8.10 (VREF); also elsewhere on the board
A0: IC10.1 (A0); also elsewhere on the board
BATT+_CHARGE: C38.1, C39.1, C43.1, C44.1, C45.1, C46.1, C47.1, R25.3; also elsewhere on the board
CONS_CHARGE_I: R23.1, U8.2 (VOUTB)
CONS_CHARGE_U: R27.1, U8.1 (VOUTA)
GNDA: C24.1, C25.2, C27.2, C29.1, C30.1, C37.2, C41.2, C48.2, C49.2, C73.2, D7.1 (K), IC5.2 (GND), IC10.3 (VSS), IC10.6 (S3), IC10.7 (S4), IC10.9 (S8), IC10.10 (S7), IC10.11 (S6), IC10.12 (S5), IC10.14 (GND), IC10.15 (A2), IC10.16 (A1), R32.2, U4.2 (V-), U4.5 (SHDN), U5.2 (V-), U5.5 (SHDN), U8.3 (GND), U8.4 (*LDAC); also elsewhere on the board
GNDPWR: C38.2, C39.2, C43.2, C44.2, C45.2, C46.2, C47.2; also elsewhere on the board
ISETA: D7.2 (A), IC10.8 (D); also elsewhere on the board
unnamed: C28.1, R26.2
unnamed: C42.1, R30.2
unnamed: C72.2, R29.1
unnamed: IC5.4 (IN+), R25.2
unnamed: IC5.5 (IN-), R25.1
unnamed: C26.2, C28.2, IC10.4 (S1), U4.1 (OUT)
unnamed: C40.2, C42.2, IC10.5 (S2), U5.1 (OUT)
unnamed: R28.1, R29.2, R31.2, R32.1
unnamed: C24.2, R23.2, U4.3 (+)
unnamed: C25.1, C26.1, R24.2, R26.1, U4.4 (-)
unnamed: C30.2, R27.2, U5.3 (+)
unnamed: C37.1, C40.1, R28.2, R30.1, U5.4 (-)
unnamed: R33.2, U8.5 (*CLR)
RELAIS_BATT_OUT: C27.1, C41.1, C73.1, IC10.2 (EN), IC10.13 (VDD), U4.6 (V+), U5.6 (V+); also elsewhere on the board
TO_ADC_BATT: C72.1, R31.1; also elsewhere on the board
TO_ADC_CURRENT_CHARGE: IC5.1 (OUT), R24.1; also elsewhere on the board
TO_SHUNT_CHARGE: R25.4; also elsewhere on the board

Notes on the sheet:
RC provoque retard Limite pics courants de départ
Filtrage Courant découpé Buck
Current sense amplifier Gain = 100 : 4V pour 40A
DAC 16 bits Dual channels
Amplificateur d'erreur Correcteur PI
CLR low = OUT 0v
Multiplexeur contrôle CC/CV uC contrôle le passage en CV quand Vbatt de l'ADC = Consigne
Tension de commande 0 < v < 0.7V
Equation Ushunt = I * Rshunt * Gain = I * 0.001 * 100 = I/10
ATTENTION MESURE LOW SIDE
CC contrôle
Commande courant : Ichannel = 0.02 * V_ISETA / Rshunt Rshunt = 0.001Ohms
ATTENTION Prendre en compte atténuation pour contrôle tension batterie
Shunt courant charge
DAC consignes
CV contrôle
Shunt
Controle
Puissance

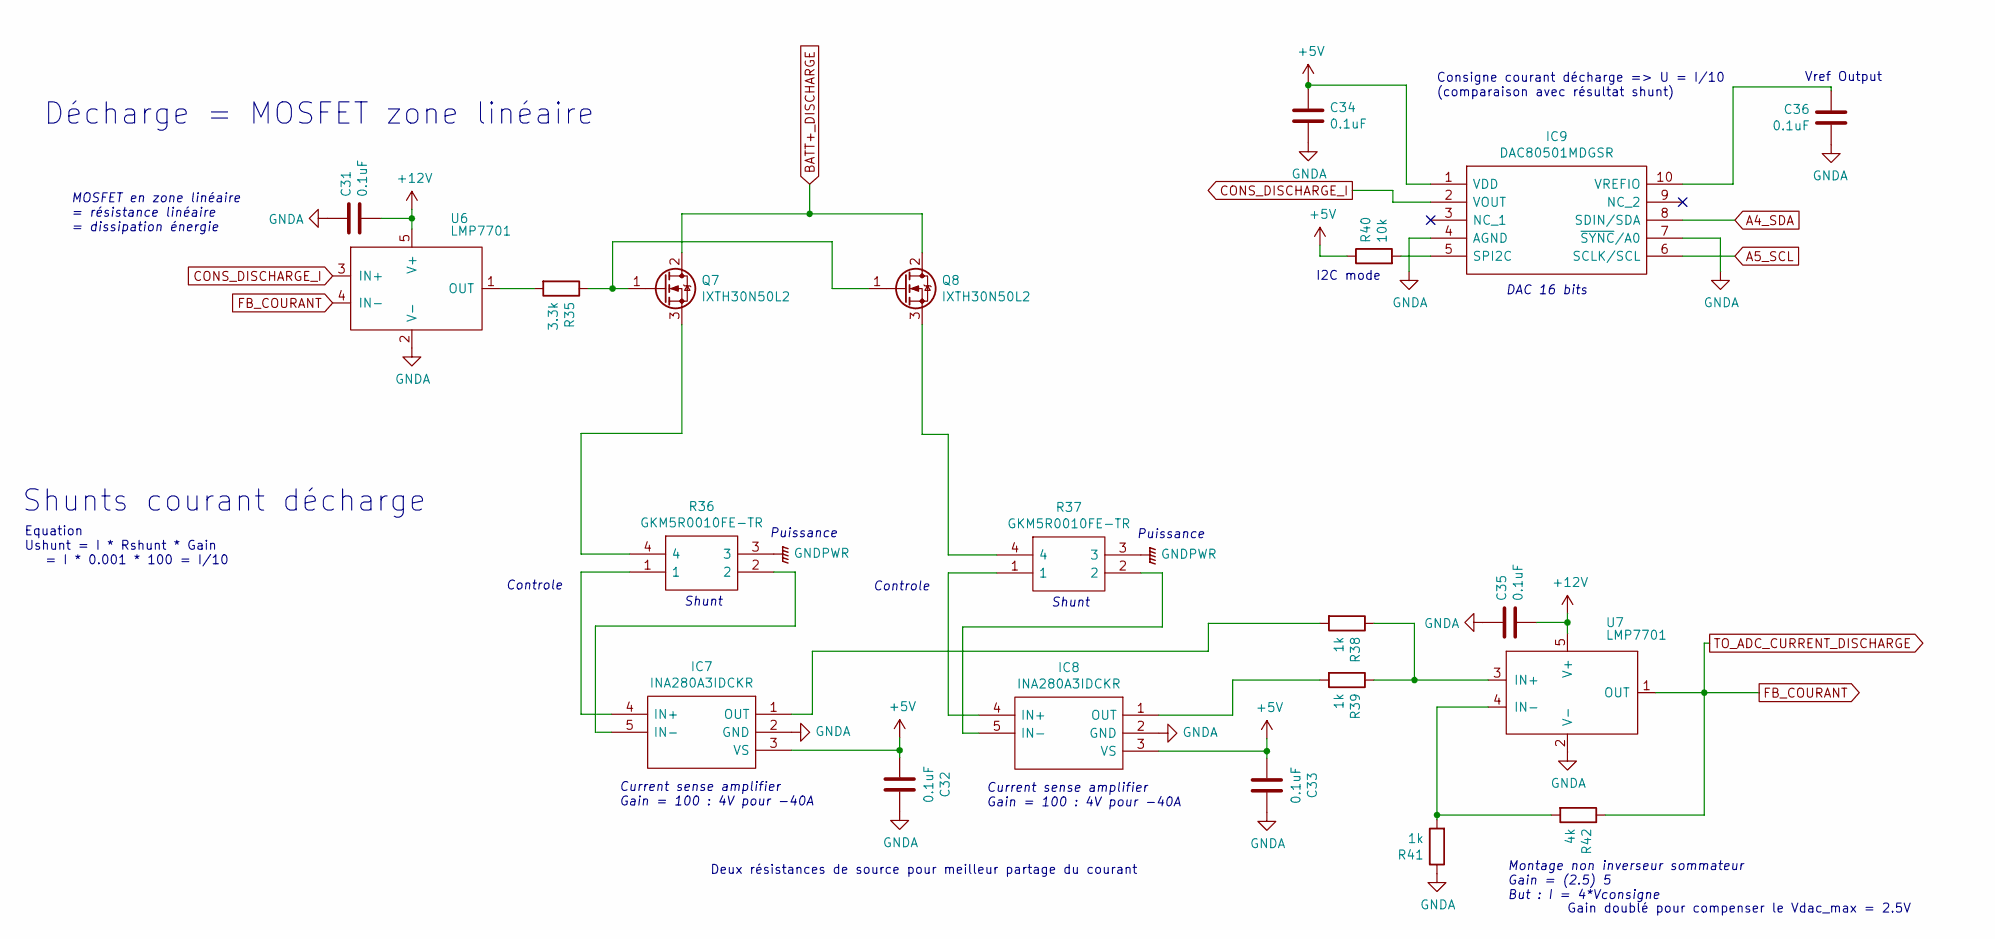
[picture p8: schematic Discharge.kicad_sch]

Parts:
C31, C32, C33, C34, C35, C36: 0.1uF; C_0805_2012Metric
IC7, IC8: INA280A3IDCKR; SOT65P210X110-5N; Manufacturer_Part_Number INA280A3IDCKR; Mouser Part Number 595-INA280A3IDCKR
IC9: DAC80501MDGSR; SOP50P490X110-10N; Manufacturer_Part_Number DAC80501MDGSR; Mouser Part Number 595-DAC80501MDGSR
Q7, Q8: IXTH30N50L2; TO-247-3_Vertical
R35: 3.3k; R_0805_2012Metric
R36, R37: GKM5R0010FE-TR; WSLP40261L000FEA; Manufacturer_Part_Number GKM5R0010FE-TR; Mouser Part Number 588-GKM5R0010FE-TR
R38, R39, R41: 1k; R_0805_2012Metric
R40: 10k; R_0805_2012Metric
R42: 4k; R_0805_2012Metric
U6, U7: LMP7701; SOT-23-5_HandSoldering

Connections:
+5V: C32.2, C33.2, C34.1, IC7.3 (VS), IC8.3 (VS), IC9.1 (VDD), R40.1; also elsewhere on the board
A4_SDA: IC9.8 (SDIN/SDA); also elsewhere on the board
A5_SCL: IC9.6 (SCLK/SCL); also elsewhere on the board
BATT+_CHARGE: Q7.2 (D), Q8.2 (D); also elsewhere on the board
CONS_DISCHARGE_I: IC9.2 (VOUT), U6.3 (IN+)
FB_COURANT: R42.1, U6.4 (IN-), U7.1 (OUT); also elsewhere on the board
GNDA: C31.1, C32.1, C33.1, C34.2, C35.1, C36.2, IC7.2 (GND), IC8.2 (GND), IC9.4 (AGND), IC9.7 (~SYNC/A0), R41.1, U6.2 (V-), U7.2 (V-); also elsewhere on the board
GNDPWR: R36.3, R37.3; also elsewhere on the board
unnamed: IC7.4 (IN+), R36.1
unnamed: IC7.5 (IN-), R36.2
unnamed: IC7.1 (OUT), R38.2
unnamed: IC8.4 (IN+), R37.1
unnamed: IC8.5 (IN-), R37.2
unnamed: IC8.1 (OUT), R39.2
unnamed: IC9.5 (SPI2C), R40.2
unnamed: C36.1, IC9.10 (VREFIO)
unnamed: Q7.1 (G), Q8.1 (G), R35.1
unnamed: Q7.3 (S), R36.4
unnamed: Q8.3 (S), R37.4
unnamed: R35.2, U6.1 (OUT)
unnamed: R38.1, R39.1, U7.3 (IN+)
unnamed: R41.2, R42.2, U7.4 (IN-)
RELAIS_BATT_OUT: C31.2, C35.2, U6.5 (V+), U7.5 (V+); also elsewhere on the board

Notes on the sheet:
I2C mode
Current sense amplifier Gain = 100 : 4V pour -40A
Shunt
Shunts courant décharge
Puissance
DAC 16 bits
Controle
Deux résistances de source pour meilleur partage du courant
MOSFET en zone linéaire = résistance linéaire = dissipation énergie
Gain doublé pour compenser le Vdac_max = 2.5V
Vref Output
Consigne courant décharge => U = I/10 (comparaison avec résultat shunt)
Montage non inverseur sommateur Gain = (2.5) 5 But : I = 4*Vconsigne
Equation Ushunt = I * Rshunt * Gain = I * 0.001 * 100 = I/10
Décharge = MOSFET zone linéaire

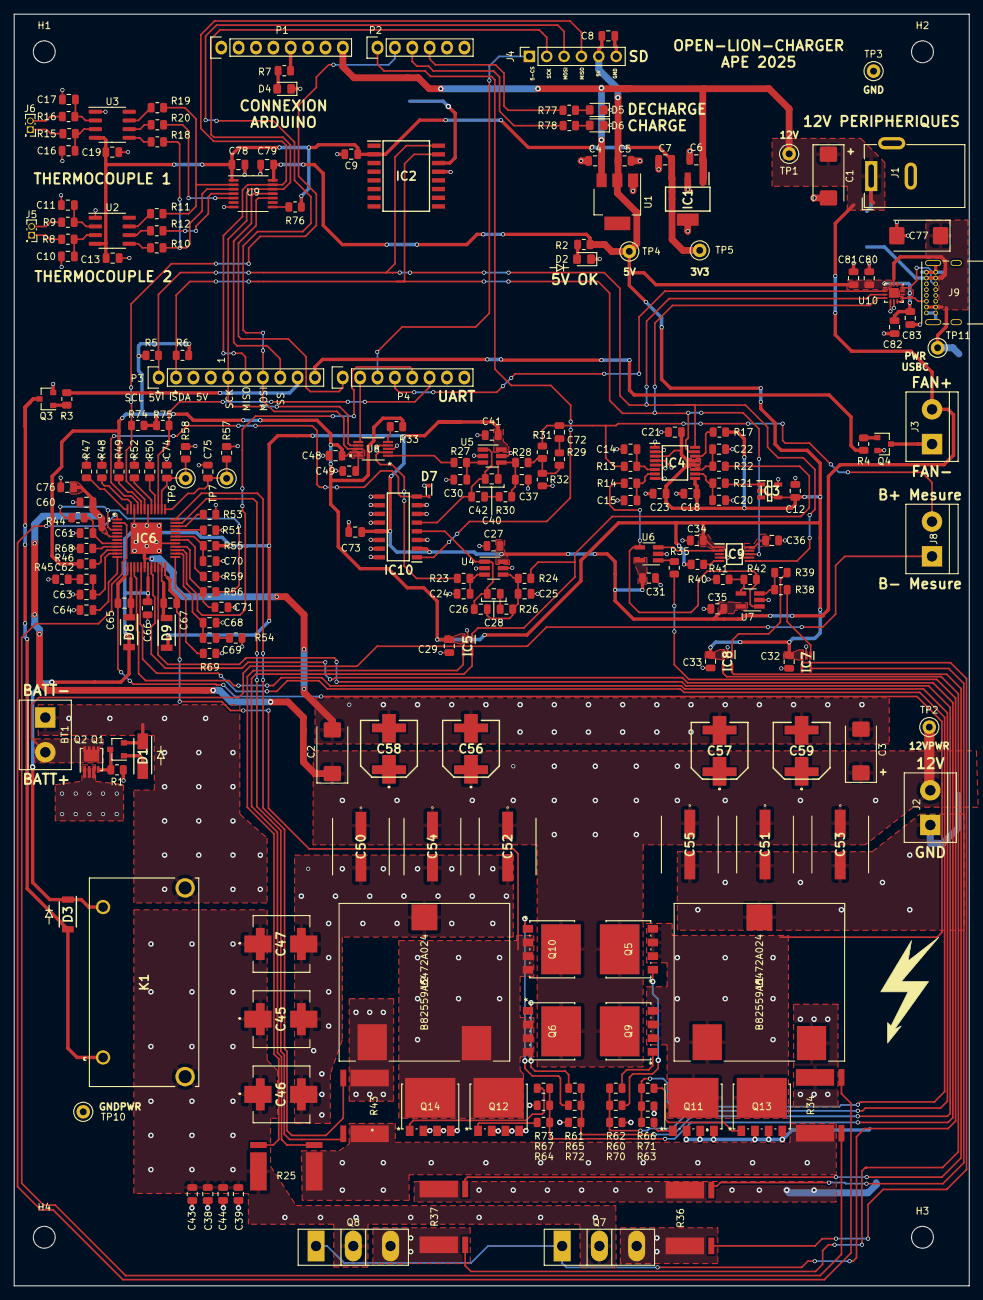
[picture p9: board open-lion-charger.kicad_pcb from above]

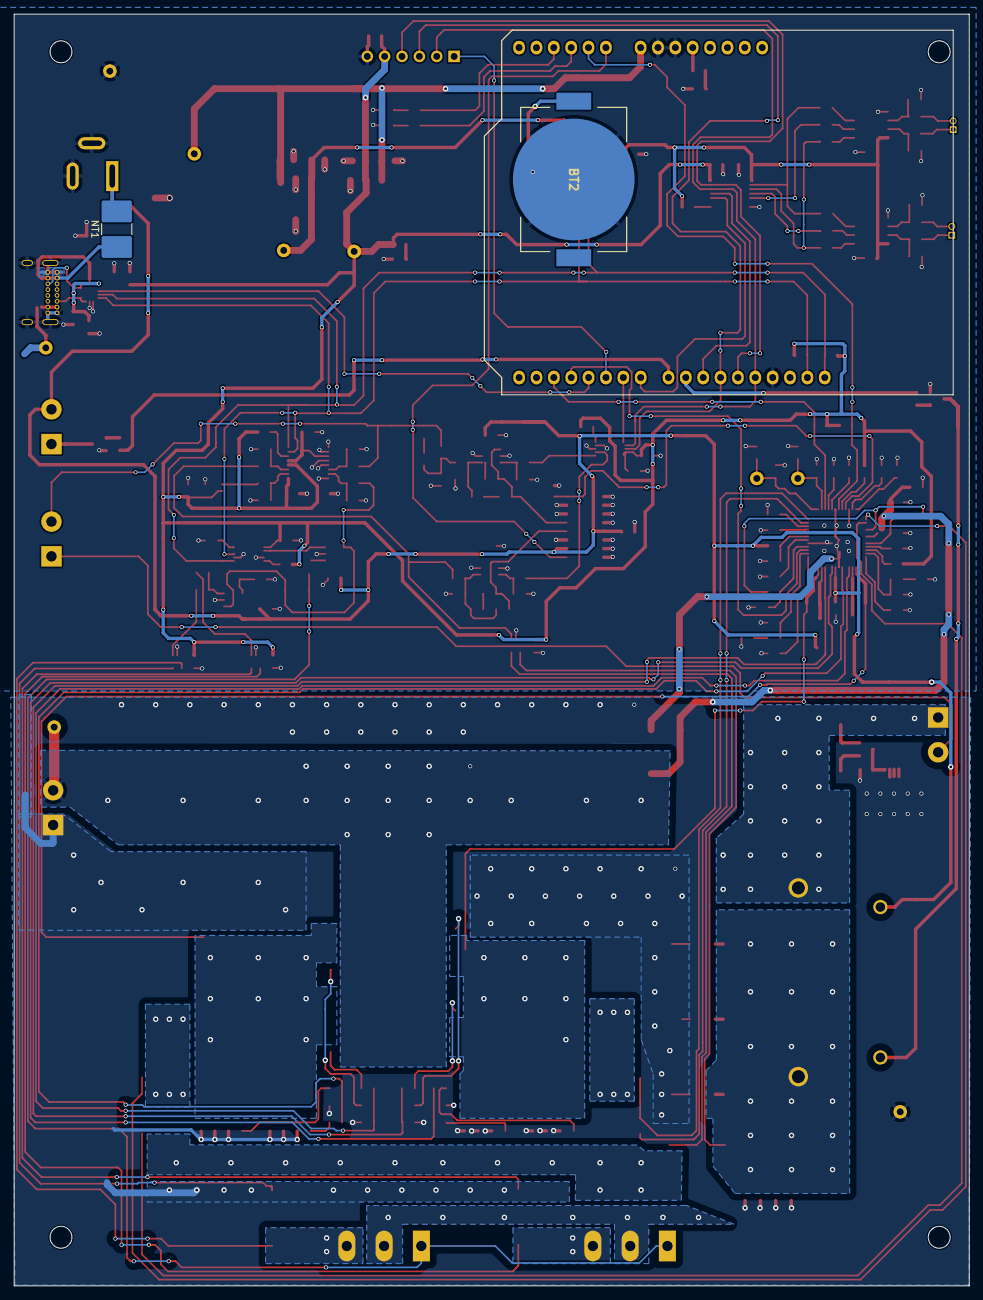
[picture p10: board open-lion-charger.kicad_pcb from below]

Board: 4 copper layers, 139.7 x 186.0 mm, 236 parts (2 on the bottom side), 146 nets.
