frchp/open-lion-charger/(commit log)

2025-02-10 Initial commit with HW ported
    [Arduino.kicad_sch, Arduino.sch, Charge.kicad_sch, Charge.sch, Charge_Discharge.sch, Charge_Phases.kicad_sch, Charge_Phases.sch, Charge_control.kicad_sch]
2025-02-10 Done with PCB review
    Warning : issue with net +12P and confusion with RELAIS_BATT_OUT
    [Arduino.kicad_sch, Arduino.sch, Charge.kicad_sch, Charge.sch, Charge_Discharge.sch, Charge_Phases.kicad_sch, Charge_Phases.sch, Charge_control.kicad_sch]
2025-02-10 Added thermal pads
    [open-lion-charger.kicad_pcb]
2025-02-10 Prepare for fab
    [Arduino.kicad_sch, Power.kicad_sch, open-lion-charger.kicad_pcb]
2025-02-10 Add fab files
    [bom.csv, designators.csv, open-lion-charger.kicad_sch, positions.csv]
